AMA-Labs/ama-algae-monitoring-buoy/Version2/pictures/servo_sensorblock.jpeg

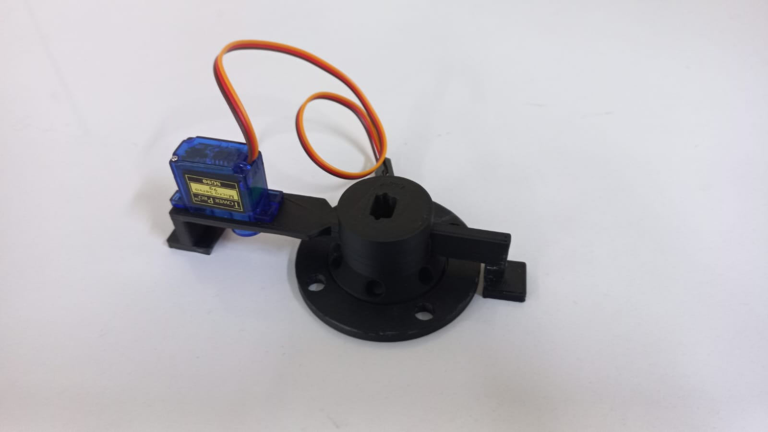
Version2/pictures/servo_sensorblock.jpeg
