AMA-Labs/ama-algae-monitoring-buoy/ObjectDetection/PlanktoScope_IsolatedSegmenter/setup.txt

pip version: 22.2.2

python -m venv venv
./venv/Scripts/Activate.ps1
python -m pip install pip==22.2.2
pip install -r requirements.txt
python main.py
