AMA-Labs/ama-algae-monitoring-buoy/Version2/buoy pcb/duba pcb.kicad_pcb

## KiCad design Version2/buoy pcb/duba pcb.kicad_pcb (2023-01-22)

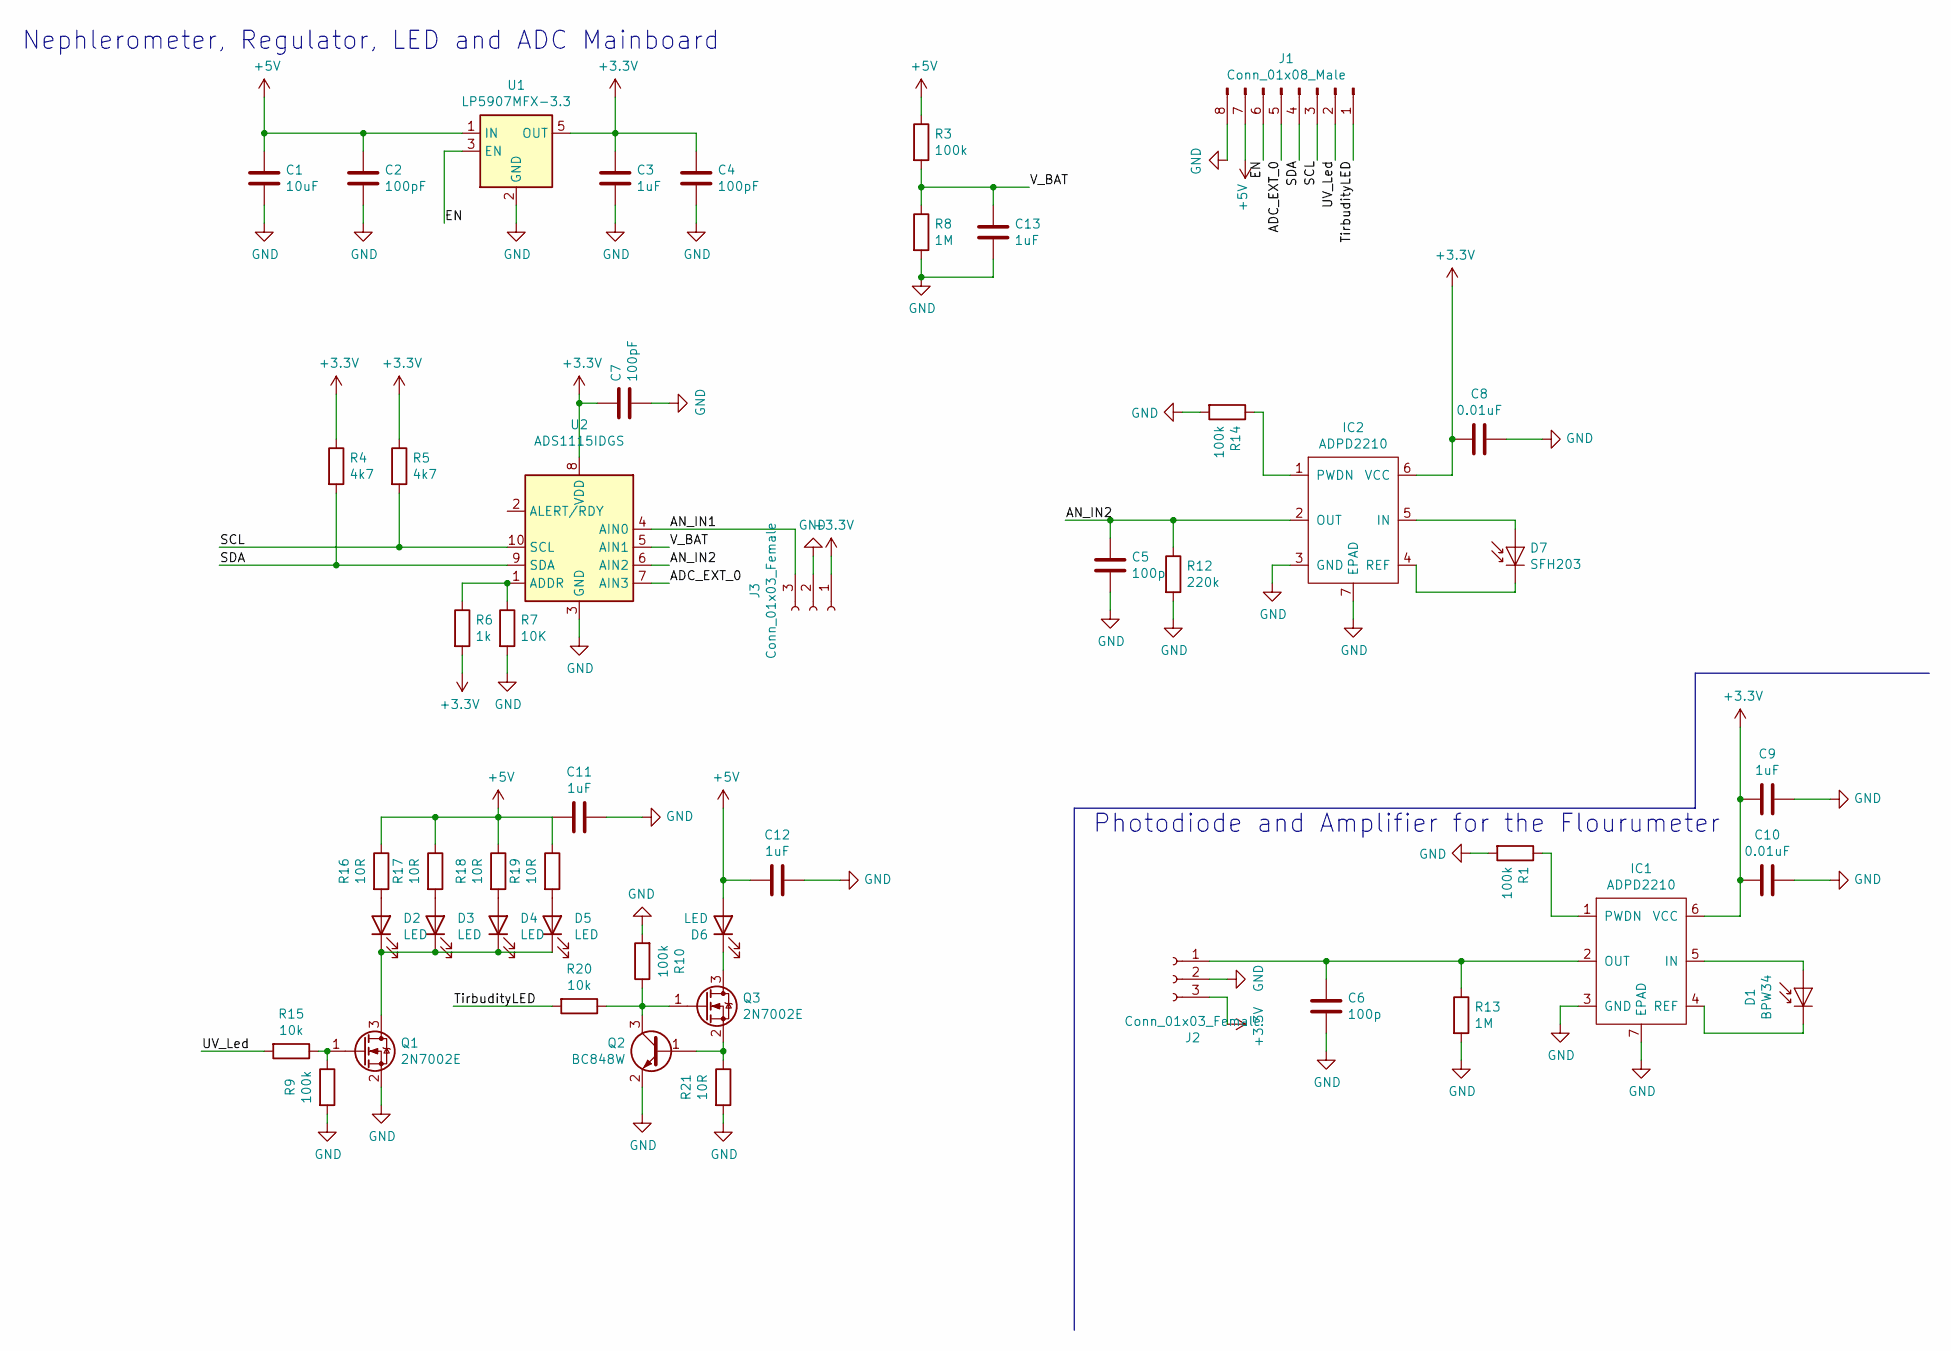
[picture p6: schematic optics.sch, Duba Optik Sensörler]

Parts:
C1: 10uF; C_0603_1608Metric
C2, C4, C7: 100pF; C_0603_1608Metric
C3, C9, C12, C13: 1uF; C_0603_1608Metric
C5, C6: 100p; C_0603_1608Metric
C8, C10: 0.01uF; C_0603_1608Metric
C11: 1uF; C_0805_2012Metric_Pad1.18x1.45mm_HandSolder
D1: BPW34; BPW34_SMD
D2, D3, D4, D5, D6: LED; LED_D5.0mm
D7: SFH203; LED_D5.0mm_IRGrey
IC1, IC2: ADPD2210; LFCSP-6
J1: Conn_01x08_Male; PinHeader_1x08_P2.54mm_Vertical
J2: Conn_01x03_Female; PinHeader_1x03_P2.54mm_Horizontal
J3: Conn_01x03_Female; PinHeader_1x03_P2.54mm_Vertical
Q1, Q3: 2N7002E; SOT-23
Q2: BC848W; SOT-23
R1, R9, R10, R14: 100k; R_0603_1608Metric
R3: 100k; R_1206_3216Metric
R4, R5: 4k7; R_0603_1608Metric
R6: 1k; R_0603_1608Metric
R7: 10K; R_0603_1608Metric
R8, R13: 1M; R_0603_1608Metric
R12: 220k; R_0603_1608Metric
R15, R20: 10k; R_0603_1608Metric
R16, R17, R18, R19, R21: 10R; R_0603_1608Metric
U1: LP5907MFX-3.3; SOT-23-5
U2: ADS1115IDGS; ADS1115_X2QFN

Connections:
+3V3: C3.1, C4.1, C7.1, C8.2, C9.2, C10.2, IC1.6 (VCC), IC2.6 (VCC), J2.3, J3.1, R4.1, R5.1, R6.2, U1.5 (OUT), U2.8 (VDD)
+5V: C1.1, C2.1, C11.2, C12.2, D6.2 (A), J1.7, R3.1, R16.1, R17.1, R18.1, R19.1, U1.1 (IN)
/optics/ADC_EXT_0: J1.5, U2.7 (AIN3)
/optics/AN_IN1: J3.3, U2.4 (AIN0)
/optics/AN_IN2: C5.1, IC2.2 (OUT), R12.1, U2.6 (AIN2)
/optics/EN: J1.6, U1.3 (EN)
/optics/SCL: J1.3, R5.2, U2.10 (SCL)
/optics/SDA: J1.4, R4.2, U2.9 (SDA)
/optics/TirbudityLED: J1.1, R20.2
/optics/UV_Led: J1.2, R15.2
/optics/V_BAT: C13.1, R3.2, R8.1, U2.5 (AIN1)
GND: C1.2, C2.2, C3.2, C4.2, C5.2, C6.2, C7.2, C8.1, C9.1, C10.1, C11.1, C12.1, C13.2, IC1.3 (GND), IC1.7 (EPAD), IC2.3 (GND), IC2.7 (EPAD), J1.8, J2.2, J3.2, Q1.2 (S), Q2.2 (E), R1.2, R7.2, R8.2, R9.2, R10.2, R12.2, R13.2, R14.2, R21.2, U1.2 (GND), U2.3 (GND)
unnamed: C6.1, IC1.2 (OUT), J2.1, R13.1
unnamed: D1.1 (K), IC1.4 (REF)
unnamed: D1.2 (A), IC1.5 (IN)
unnamed: D2.1 (K), D3.1 (K), D4.1 (K), D5.1 (K), Q1.3 (D)
unnamed: D2.2 (A), R16.2
unnamed: D3.2 (A), R17.2
unnamed: D4.2 (A), R18.2
unnamed: D5.2 (A), R19.2
unnamed: D6.1 (K), Q3.3 (D)
unnamed: D7.1 (K), IC2.4 (REF)
unnamed: D7.2 (A), IC2.5 (IN)
unnamed: IC1.1 (PWDN), R1.1
unnamed: IC2.1 (PWDN), R14.1
unnamed: Q1.1 (G), R9.1, R15.1
unnamed: Q2.1 (B), Q3.2 (S), R21.1
unnamed: Q2.3 (C), Q3.1 (G), R10.1, R20.1
unnamed: R6.1, R7.1, U2.1 (ADDR)

Notes on the sheet:
Photodiode and Amplifier for the Flourumeter
Nephlerometer, Regulator, LED and ADC Mainboard

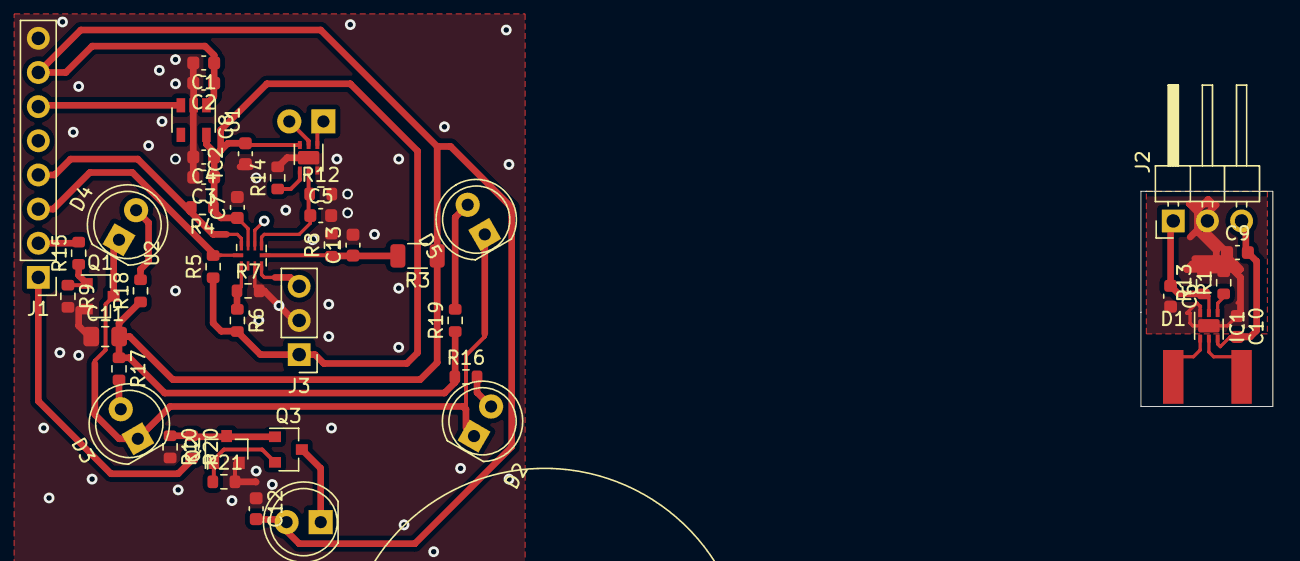
[picture p7: board duba pcb.kicad_pcb from above]

Board: 2 copper layers, 9.8 x 16.0 mm, 49 parts (1 on the bottom side), 29 nets.
