AMA-Labs/ama-algae-monitoring-buoy/(commit log)

2022-07-29 Utility to make training subsets
    This is currently not finished as it doesn't create the configuration file and it has not been bug tested yet.
2023-01-13 Add files via upload
    In-house segmenter WIP. Background remover needs work - island identified but not properly separated. Currently not usable in production setting.
2023-01-22 adding new files
    [duba pcb.kicad_pcb, duba pcb.sch, guc_yonetimi.sch, optics.sch, tdssensor.sch, uC.sch]
